jukolein/W132/(commit log)

2021-10-06 Firmware 1.4 adapted for ESP32
    alterations of the code so it works on an ESP32
2021-10-06 BIN of FW-version 1.4_32
    BIN that can be flashed to an ESP32
2021-10-13 Libraries for the Arduino IDE added
2021-10-20 Add files via upload
    sketches for the wiring added
2021-10-20 Add files via upload
    sketches of the wiring added
